anil08607/stm32-smartwatch/release/README.md

# Engineering review package

Status: REVIEW_ONLY_NOT_ORDER_APPROVED. Native DRC/ERC and routed-viewer checks can pass while physical qualification remains pending. Read readiness.json, qualification.json, ../docs/fabrication.md and ../docs/assembly.md before ordering.

Gerbers, Excellon drills, top-only SMT BOM/CPL and complete purchase list share the same reviewed source. M1 is excluded from SMT/paste. Stock is not reserved.
