anil08607/stm32-smartwatch/mechanical/index.html

ANIL / HARDWARE V1

# nRF52810 Smartwatch

Provisional fit model

Compact and exploded assembly with the full electronics and mechanical parts list.

PCB: 46 × 46 × 1 mm
Case: 54 × 54 × 18 mm
Strap: 22 mm
Loading assembly…

Explode assembly Show internalsFit whole watchInspect watch headInspect USB accessInspect centred buttons

Compact GLBExploded GLB

Supplier fit, flex routing, battery pack protection, RF tuning and first-article tests remain release gates. Component bodies and harnesses are envelopes. The clock face is illustrative.

Loading…
