anil08607/stm32-smartwatch/__snapshots__/SMARTWATCH_V1_STM32.circuit-3d.snap.png

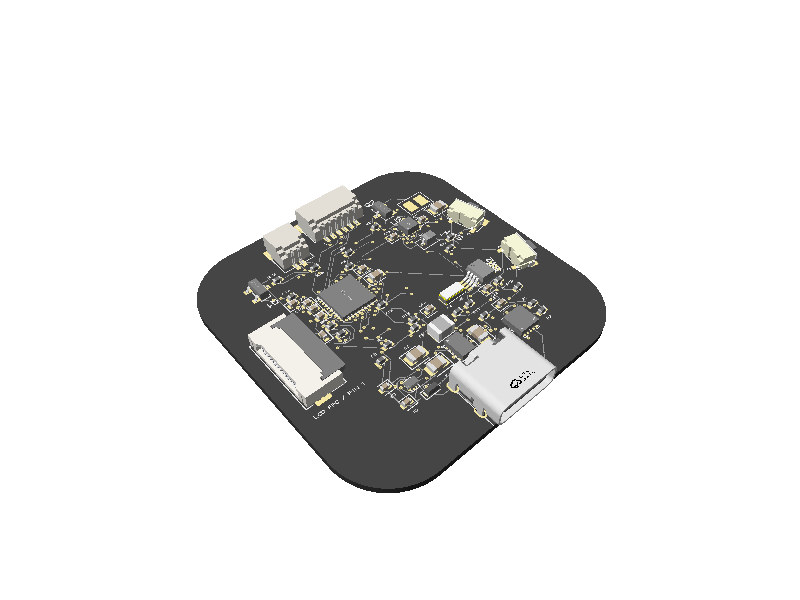
__snapshots__/SMARTWATCH_V1_STM32.circuit-3d.snap.png
