anil08607/stm32-smartwatch/bom.csv

Reference | Quantity per watch | Manufacturer part | Supplier code | Purchase URL | Assembly stage | Procurement status
PCB1 | 1 | 46 x 46 mm, four layers, 1 mm FR-4, ENIG; release Gerbers and drills |  | https://jlcpcb.com/ | Bare PCB fabrication | Fabricator stackup, impedance and engineering release approval pending
SMT_SERVICE | 1 | Top-side SMT assembly of 70 fitted parts; exact BOM/CPL |  | https://jlcpcb.com/pcb-assembly | Before external product assembly | Assembler orientation, stencil and inspection approval pending
J1 | 1 | TYPE-C-31-M-12 | C165948 | https://jlcpcb.com/partdetail/C165948 | Top SMT assembly | Inventory available as of 2026-10-15T14:10:25.200Z; not reserved
U3 | 1 | HUSB238_002DD | C7471904 | https://jlcpcb.com/partdetail/C7471904 | Top SMT assembly | Inventory available as of 2026-10-15T14:10:25.200Z; not reserved
R18 | 1 | 0402WGF100JTCE | C25077 | https://jlcpcb.com/partdetail/C25077 | Top SMT assembly | Inventory available as of 2026-10-15T14:10:25.200Z; not reserved
C6,C1,C3,C11 | 4 | CL05A105KA5NQNC | C52923 | https://jlcpcb.com/partdetail/C52923 | Top SMT assembly | Inventory available as of 2026-10-15T14:10:25.200Z; not reserved
R1,R2 | 2 | 0402WGF0000TCE | C17168 | https://jlcpcb.com/partdetail/C17168 | Top SMT assembly | Inventory available as of 2026-10-15T14:10:25.200Z; not reserved
D1 | 1 | LESD5Z5.0CT1G | C136167 | https://jlcpcb.com/partdetail/C136167 | Top SMT assembly | Inventory available as of 2026-10-15T14:10:25.200Z; not reserved
U5 | 1 | BQ25180YBGR | C3682423 | https://jlcpcb.com/partdetail/C3682423 | Top SMT assembly | Inventory available as of 2026-10-15T14:10:25.200Z; not reserved
C2,C4 | 2 | CL21A106KAYNNNE | C15850 | https://jlcpcb.com/partdetail/C15850 | Top SMT assembly | Inventory available as of 2026-10-15T14:10:25.200Z; not reserved
J5,J2 | 2 | SM02B-SRSS-TB(LF)(SN) | C160402 | https://jlcpcb.com/partdetail/C160402 | Top SMT assembly | Inventory available as of 2026-10-15T14:10:25.200Z; not reserved
R7,R10,R17 | 3 | 0402WGF1002TCE | C25744 | https://jlcpcb.com/partdetail/C25744 | Top SMT assembly | Inventory available as of 2026-10-15T14:10:25.200Z; not reserved
U6 | 1 | TPS63802DLAR | C2845237 | https://jlcpcb.com/partdetail/C2845237 | Top SMT assembly | Inventory available as of 2026-10-15T14:10:25.200Z; not reserved
L1 | 1 | DFE252012P-R47M=P2 | C237552 | https://jlcpcb.com/partdetail/C237552 | Top SMT assembly | Inventory available as of 2026-10-15T14:10:25.200Z; not reserved
C5,C23 | 2 | CL21A226MAQNNNE | C45783 | https://jlcpcb.com/partdetail/C45783 | Top SMT assembly | Inventory available as of 2026-10-15T14:10:25.200Z; not reserved
R4 | 1 | RC0402FR-07510KL | C137961 | https://jlcpcb.com/partdetail/C137961 | Top SMT assembly | Inventory available as of 2026-10-15T14:10:25.200Z; not reserved
R5,R6,R16,R19,R20,R22 | 6 | 0402WGF1003TCE | C25741 | https://jlcpcb.com/partdetail/C25741 | Top SMT assembly | Inventory available as of 2026-10-15T14:10:25.200Z; not reserved
U1 | 1 | NRF52810-QFAA-R | C141828 | https://jlcpcb.com/partdetail/C141828 | Top SMT assembly | Inventory available as of 2026-10-15T14:10:25.200Z; not reserved
C8,C10,C13,C14,C15,C16,C17,C22,C25,C26,C27 | 11 | CC0402KRX7R7BB104 | C60474 | https://jlcpcb.com/partdetail/C60474 | Top SMT assembly | Inventory available as of 2026-10-15T14:10:25.200Z; not reserved
C9 | 1 | 0402CG101J500NT | C1546 | https://jlcpcb.com/partdetail/C1546 | Top SMT assembly | Inventory available as of 2026-10-15T14:10:25.200Z; not reserved
C12 | 1 | CL10A475KO8NNNC | C19666 | https://jlcpcb.com/partdetail/C19666 | Top SMT assembly | Inventory available as of 2026-10-15T14:10:25.200Z; not reserved
R8,R9 | 2 | 0402WGF4701TCE | C25900 | https://jlcpcb.com/partdetail/C25900 | Top SMT assembly | Inventory available as of 2026-10-15T14:10:25.200Z; not reserved
R12 | 1 | 0402WGF1004TCE | C26083 | https://jlcpcb.com/partdetail/C26083 | Top SMT assembly | Inventory available as of 2026-10-15T14:10:25.200Z; not reserved
R13 | 1 | 0402WGF3303TCE | C25778 | https://jlcpcb.com/partdetail/C25778 | Top SMT assembly | Inventory available as of 2026-10-15T14:10:25.200Z; not reserved
J3 | 1 | SM06B-SRSS-TB(LF)(SN) | C160405 | https://jlcpcb.com/partdetail/C160405 | Top SMT assembly | Inventory available as of 2026-10-15T14:10:25.200Z; not reserved
J4 | 1 | AFC24-S15FIA-00 | C6709462 | https://jlcpcb.com/partdetail/C6709462 | Top SMT assembly | Inventory available as of 2026-10-15T14:10:25.200Z; not reserved
R14 | 1 | 0402WGF220JTCE | C25092 | https://jlcpcb.com/partdetail/C25092 | Top SMT assembly | Inventory available as of 2026-10-15T14:10:25.200Z; not reserved
Q1 | 1 | 2N7002 | C8545 | https://jlcpcb.com/partdetail/C8545 | Top SMT assembly | Inventory available as of 2026-10-15T14:10:25.200Z; not reserved
R15,R21 | 2 | 0402WGF1000TCE | C25076 | https://jlcpcb.com/partdetail/C25076 | Top SMT assembly | Inventory available as of 2026-10-15T14:10:25.200Z; not reserved
U2 | 1 | BMA456 | C189518 | https://jlcpcb.com/partdetail/C189518 | Top SMT assembly | Inventory available as of 2026-10-15T14:10:25.200Z; not reserved
U4 | 1 | PCF8563TS/5,118 | C27397 | https://jlcpcb.com/partdetail/C27397 | Top SMT assembly | Inventory available as of 2026-10-15T14:10:25.200Z; not reserved
Y1 | 1 | FC-135 32.7680KA-AG3 | C7275970 | https://jlcpcb.com/partdetail/C7275970 | Top SMT assembly | Inventory available as of 2026-10-15T14:10:25.200Z; not reserved
SW1,SW2 | 2 | TS-1806SA-2x4x3.5DY-180X | C51927172 | https://jlcpcb.com/partdetail/C51927172 | Top SMT assembly | Inventory available as of 2026-10-15T14:10:25.200Z; not reserved
Q2 | 1 | AO3400A | C20917 | https://jlcpcb.com/partdetail/C20917 | Top SMT assembly | Inventory available as of 2026-10-15T14:10:25.200Z; not reserved
D2 | 1 | 1N5819WS | C5451629 | https://jlcpcb.com/partdetail/C5451629 | Top SMT assembly | Inventory available as of 2026-10-15T14:10:25.200Z; not reserved
Y2 | 1 | X201632MKB4SI | C718072 | https://jlcpcb.com/partdetail/C718072 | Top SMT assembly | Inventory available as of 2026-10-15T14:10:25.200Z; not reserved
Y3 | 1 | ABS07-32.768KHZ-9-T | C179635 | https://jlcpcb.com/partdetail/C179635 | Top SMT assembly | Inventory available as of 2026-10-15T14:10:25.200Z; not reserved
ANT1 | 1 | RFANT3216120A5T | C127629 | https://jlcpcb.com/partdetail/C127629 | Top SMT assembly | Inventory available as of 2026-10-15T14:10:25.200Z; not reserved
L2 | 1 | LQG15HS3N9S02D | C77109 | https://jlcpcb.com/partdetail/C77109 | Top SMT assembly | Inventory available as of 2026-10-15T14:10:25.200Z; not reserved
L3 | 1 | LQG15HS6N8J02D | C77110 | https://jlcpcb.com/partdetail/C77110 | Top SMT assembly | Inventory available as of 2026-10-15T14:10:25.200Z; not reserved
C24 | 1 | GJM1555C1HR80WB01D | C88902 | https://jlcpcb.com/partdetail/C88902 | Top SMT assembly | Inventory available as of 2026-10-15T14:10:25.200Z; not reserved
C28,C29,C30,C31 | 4 | 0402CG120J500NT | C1547 | https://jlcpcb.com/partdetail/C1547 | Top SMT assembly | Inventory available as of 2026-10-15T14:10:25.200Z; not reserved
LCD1 | 1 | ER-TFT1.28-3, no-touch, 15-pin 0.5 mm FPC |  | https://www.buydisplay.com/1-28-inch-tft-lcd-display-240x240-round-circle-screen-for-smart-watch | After reflow; verify flex contact orientation | supplier confirmation required
BT1 | 1 | LP403035 3.7 V 400 mAh protected 1S LiPo; confirmed JST-SH polarity and protection required |  | https://www.lipolbattery.com/LiPo-Battery-Datahseet/LiPo_Battery_LP403035_3.7V_400mAh.pdf | Qualified custom pack order; do not substitute bare unprotected cell | pack quote, protection circuit and lead drawing required
NTC1 | 1 | SEMITEC 103AT-2 10 kohm 3435 K thermistor |  | https://www.arrow.com/en/products/103at-2/semitec-corporation | Insulate and bond to pack; connect to J5; test open/short faults | supplier confirmation required
M1 | 1 | LCM1234A3523F wire-lead vibration motor | C7424783 | https://www.lcsc.com/product-detail/C7424783.html | Hand-solder to M1 pads; no SMT paste or CPL entry | supplier confirmation required
H_BAT,H_NTC | 2 | JST SHR-02V-S housing with two SSH-003T-P0.2 contacts, assembled 28 AWG lead, nominal 50 mm |  | https://www.jst-mfg.com/product/index.php?series=231 | One polarized battery lead, one marked NTC lead; verify actual cut length | harness quote required
H_SWD | 1 | JST SHR-06V-S housing with six SSH-003T-P0.2 contacts and probe-specific adapter |  | https://www.jst-mfg.com/product/index.php?series=231 | Programming equipment; custom pinout in hardware-contract.json | harness quote required
CASE1,BEZEL1,RETAINER1,PLUNGER1,PLUNGER2 | 1 | Custom five-part polymer enclosure set from mechanical/ STL models |  | https://3d.jlcpcb.com/ | Prototype print quote; inspect fit and refine before wearable use | custom manufacture; no stock claim
LENS1 | 1 | Custom 38 x 40 x 1 mm clear polycarbonate lens, R3 corners |  | https://www.protolabs.com/services/cnc-machining/ | Custom cut lens; bond after display fit check | custom quote required
FAST1 | 4 | M2 x 8 mm screws with M2 heat-set inserts sized to enclosure drawing |  | https://www.mcmaster.com/heat-set-inserts/ | Case fastening; verify insert OD and installed depth with supplier drawing | exact insert selection and fit test required
STRAP1 | 1 | 22 mm silicone quick-release strap with two matching spring bars |  | https://www.bartonwatchbands.com/collections/22mm-watch-bands | Final mechanical assembly; verify lug and pin fit | supplier confirmation required
ADH1 | 1 | Electronics-safe 0.10 mm display seat tape, 0.20 mm lens perimeter bond, 0.5 mm battery cushion and insulated NTC bond; exact compatible grades pending |  | https://www.3m.com/3M/en_US/bonding-and-assembly-us/ | Select materials compatible with pack supplier and temperature limits | exact adhesive selection required
TOOL_SWD | 1 | Nordic nRF52 DK debug-out or compatible SEGGER J-Link |  | https://www.nordicsemi.com/Products/Development-hardware/nRF52-DK | Reusable programming/test equipment; not fitted to watch | supplier confirmation required
TOOL_USB | 1 | 5 V USB-C source and USB-C cable |  | https://www.digikey.com/en/products/filter/usb-cables/455 | Charging/test equipment; cable overmould at most 12 mm wide x 6 mm high within checked side-opening envelope; verify full engagement | exact cable/source selection required
