anil08607/stm32-smartwatch/mechanical/case-base.stl

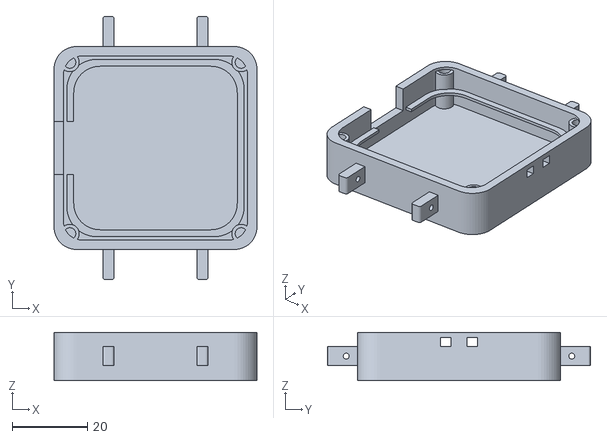
[picture p2: CAD file, 2026-10-15]
mechanical/case-base.stl
54.0 x 70.0 x 12.8
