anil08607/stm32-smartwatch/mechanical/display-retainer.stl

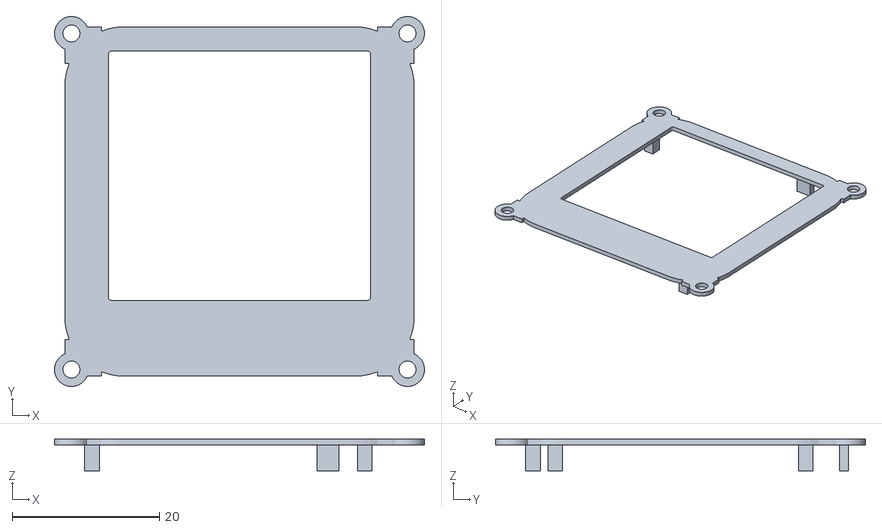
[picture p3: CAD file, 2026-10-15]
mechanical/display-retainer.stl
50.2 x 50.2 x 4.30
