anil08607/stm32-smartwatch/mechanical/button-plunger-SW1.stl

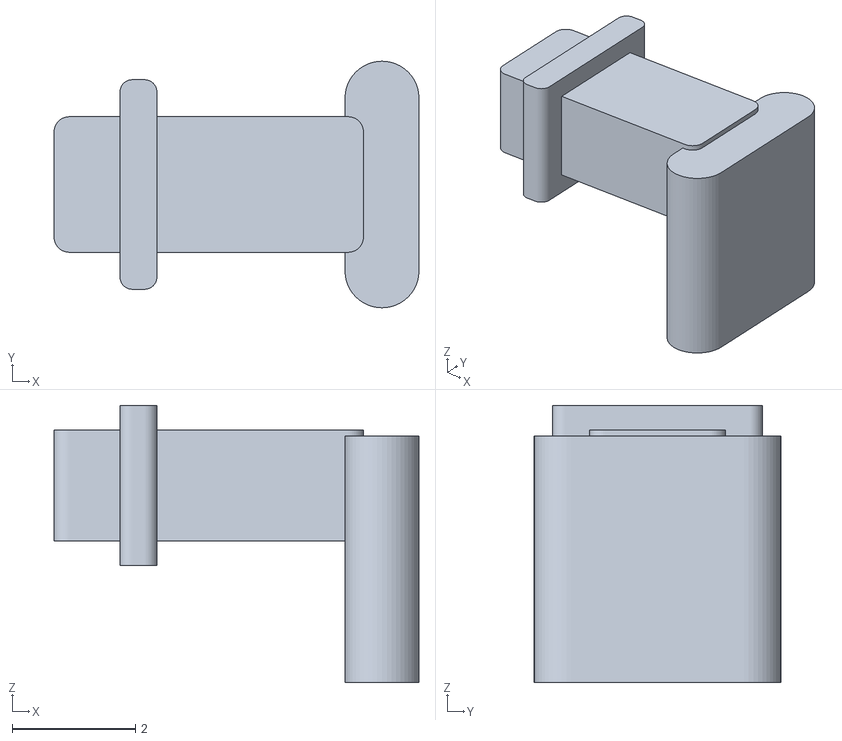
[picture p4: CAD file, 2026-10-15]
mechanical/button-plunger-SW1.stl
5.92 x 4.00 x 4.50
