anil08607/stm32-smartwatch/mechanical/bezel.stl

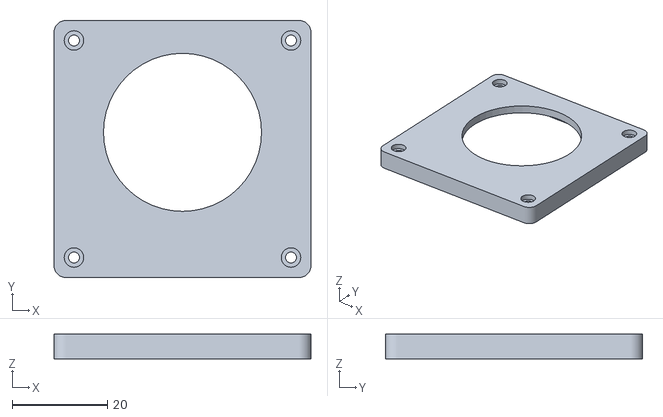
[picture p5: CAD file, 2026-10-15]
mechanical/bezel.stl
54.0 x 54.0 x 5.20
