anil08607/stm32-smartwatch/mechanical/button-plunger-10.stl

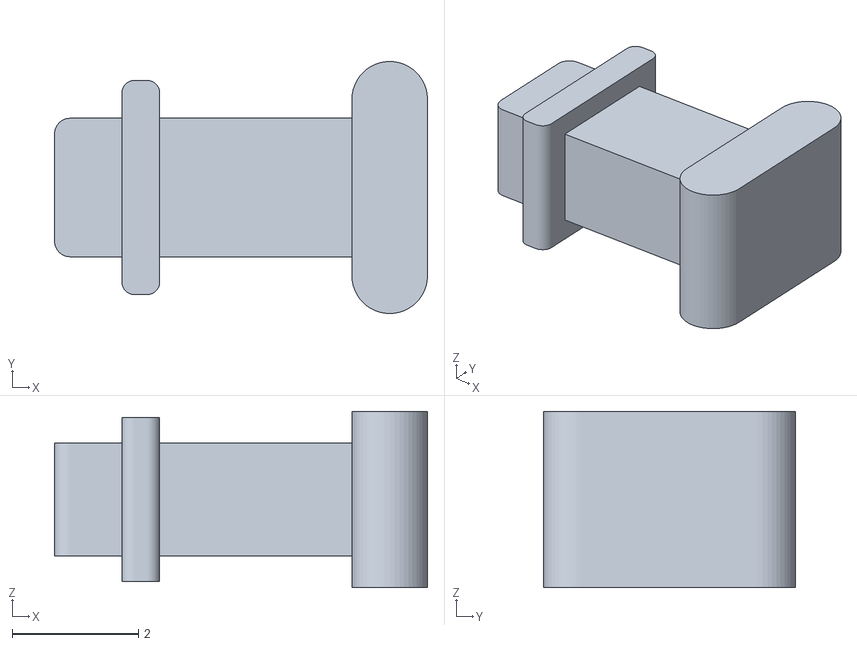
[picture p6: CAD file, 2026-10-15]
mechanical/button-plunger-10.stl
5.92 x 4.00 x 2.80
