anil08607/stm32-smartwatch/(list of files, cad)

Other CAD files:
mechanical/button-plunger-SW2.stl
mechanical/button-plunger-2.stl
