anil08607/stm32-smartwatch/(list of files, drawings)

Other design files:
docs/checks/schematic-style.json
hardware/schematic-paths.json
routing/native/input.dsn
