anil08607/stm32-smartwatch/hardware/smartwatch-nrf52810.kicad_pcb

## KiCad design hardware/smartwatch-nrf52810.kicad_pcb (2026-10-15)

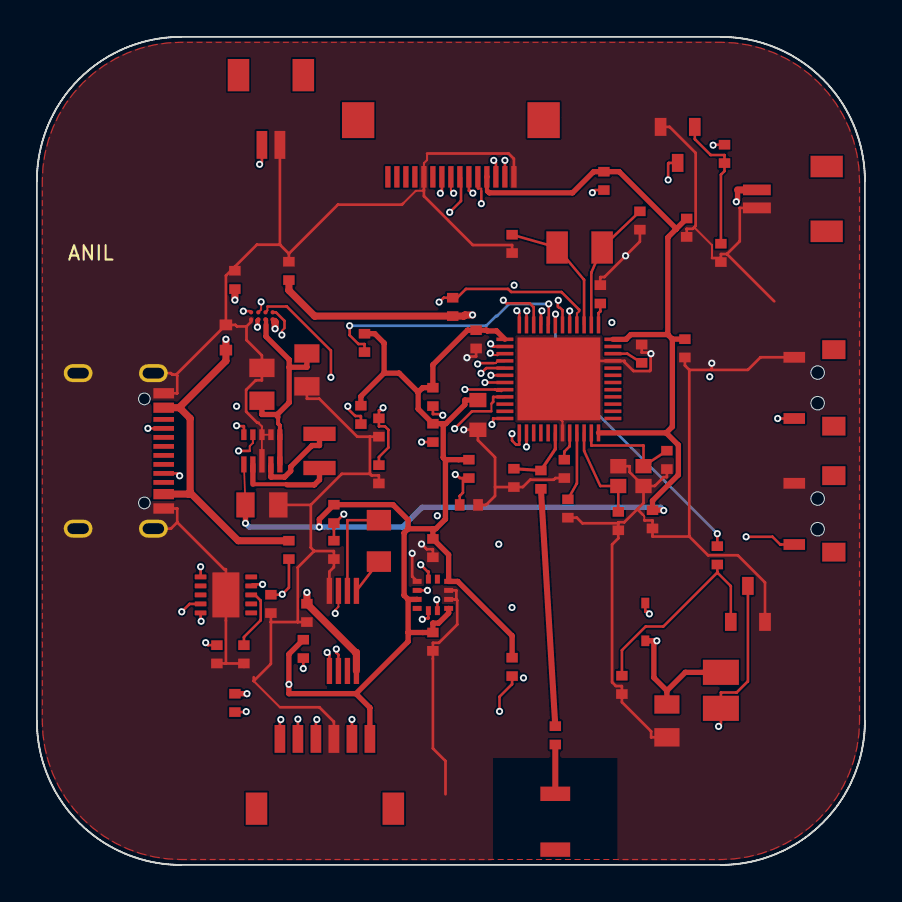
[picture p7: board smartwatch-nrf52810.kicad_pcb from above]

Board: 4 copper layers, 46.0 x 46.0 mm, 71 parts (0 on the bottom side), 53 nets.

Parts:
ANT1: RFANT3216120A5T; ANT1_exact
C1: 1uF; C1_exact
C2: 10uF; C2_exact
C3: 1uF; C3_exact
C4: 10uF; C4_exact
C5: 22uF; C5_exact
C6: 1uF; C6_exact
C8: 100nF; C8_exact
C9: 100pF; C9_exact
C10: 100nF; C10_exact
C11: 1uF; C11_exact
C12: 4.7uF; C12_exact
C13: 100nF; C13_exact
C14: 100nF; C14_exact
C15: 100nF; C15_exact
C16: 100nF; C16_exact
C17: 100nF; C17_exact
C22: 100nF; C22_exact
C23: 22uF; C23_exact
C24: 0.8pF; C24_exact
C25: 100nF; C25_exact
C26: 100nF; C26_exact
C27: 100nF; C27_exact
C28: 12pF; C28_exact
C29: 12pF; C29_exact
C30: 12pF; C30_exact
C31: 12pF; C31_exact
D1: D; D1_exact
D2: D; D2_exact
J1: J1; J1_exact
J2: J2; J2_exact
J3: J3; J3_exact
J4: J4; J4_exact
J5: J5; J5_exact
L1: 470nH; L1_exact
L2: 3.9nH; L2_exact
L3: 6.8nH; L3_exact
M1: M1; M1_exact
Q1: Q1; Q1_exact
Q2: Q2; Q2_exact
R1: 0Ω; R1_exact
R2: 0Ω; R2_exact
R4: 510kΩ; R4_exact
R5: 100kΩ; R5_exact
R6: 100kΩ; R6_exact
R7: 10kΩ; R7_exact
R8: 4.7kΩ; R8_exact
R9: 4.7kΩ; R9_exact
R10: 10kΩ; R10_exact
R12: 1MΩ; R12_exact
R13: 330kΩ; R13_exact
R14: 22Ω; R14_exact
R15: 100Ω; R15_exact
R16: 100kΩ; R16_exact
R17: 10kΩ; R17_exact
R18: 10Ω; R18_exact
R19: 100kΩ; R19_exact
R20: 100kΩ; R20_exact
R21: 100Ω; R21_exact
R22: 100kΩ; R22_exact
SW1: SW1; SW1_exact
SW2: SW2; SW2_exact
U1: NRF52810-QFAA-R; U1_exact
U2: BMA456; U2_exact
U3: HUSB238_002DD; U3_exact
U4: PCF8563TS/5,118; U4_exact
U5: BQ25180YBGR; U5_exact
U6: TPS63802DLAR; U6_exact
Y1: Y1; Y1_exact
Y2: Y2; Y2_exact
Y3: Y3; Y3_exact

Connections:
BAT: C3.1, C22.1, J2.1, R12.1, U4.8, U5.6
BAT_ADC: C14.1, R12.2, R13.1, U1.4
BMA_INT1: U1.18, U2.5
BMA_INT2: U1.19, U2.6
BQ_TS: J5.1, U5.7
BUCK_FB: R4.2, R5.1, U6.4
BUCK_L1: L1.1, U6.9
BUCK_L2: L1.2, U6.7
BUCK_PG: R6.2, U6.5
BUTTON1: R19.2, SW1.1, U1.5
BUTTON2: R20.2, SW2.1, U1.6
CHG_INT: R7.2, U1.8, U5.1
DEBUG_GPIO: J3.6, U1.21
DISPLAY_LEDA: J4.3, R14.2
DISPLAY_LED_K: J4.2, Q1.3
GND: C1.2, C2.2, C3.2, C4.2, C5.2, C6.2, C8.2, C9.2, C10.2, C11.2, C12.2, C13.2, C14.2, C15.2, C16.2, C17.2, C22.2, C23.2, C24.2, C25.2, C26.2, C27.2, C28.2, C29.2, C30.2, C31.2, D1.1, J1.1, J1.12, J1.13, J1.14, J1.15, J1.16, J2.2, J3.3, J4.1, J4.11, J5.2, Q1.2, Q2.2, R1.2, R2.2, R5.2, R13.2, R16.2, R22.2, SW1.2, SW2.2, U1.31, U1.45, U1.49, U2.1, U2.8, U2.9, U3.11, U4.4, U5.8, U6.2, U6.3, U6.8, Y2.2, Y2.4
HF_X1: C28.1, U1.34, Y2.1
HF_X2: C29.1, U1.35, Y2.3
I2C_SCL: R8.2, U1.16, U2.12, U4.6, U5.3
I2C_SDA: R9.2, U1.17, U2.2, U4.5, U5.5
LCD_BL: R15.1, U1.15
LCD_BL_GATE: Q1.1, R15.2, R16.1
LCD_CS: J4.6, U1.9
LCD_DC: J4.5, U1.12
LCD_MOSI: J4.8, U1.11
LCD_RESET: J4.9, U1.14
LCD_SCK: J4.7, U1.10
LF_X1: C30.1, U1.2, Y3.1
LF_X2: C31.1, U1.3, Y3.2
MOTOR_EN: R21.1, U1.7
MOTOR_GATE: Q2.1, R21.2, R22.1
MOTOR_NEG: D2.1, M1.2, Q2.3
NRF_DEC1: C8.1, U1.1
NRF_DEC2: C9.1, U1.32
NRF_DEC3: C10.1, U1.33
NRF_DEC4: C11.1, U1.46
NRST: C13.1, J3.5, R10.2, U1.24
PD_ISET: R2.1, U3.9
PD_VIN: C6.1, R18.2, U3.1
PD_VSET: R1.1, U3.8
RF_50: L2.2, L3.1
RF_ANT: C24.1, L2.1, U1.30
RF_FEED: ANT1.1, L3.2
RTC_INT: R17.2, U1.20, U4.3
RTC_OSCI: U4.1, Y1.1
RTC_OSCO: U4.2, Y1.2
SWCLK: J3.4, U1.25
SWDIO: J3.2, U1.26
SYS: C2.1, C4.1, U5.4, U6.1, U6.10
USB5V: C1.1, D1.2, J1.2, J1.11, R18.1, U5.2
USB_CC1: J1.4, U3.4
USB_CC2: J1.9, U3.5
V3V0: C5.1, C12.1, C15.1, C16.1, C17.1, C23.1, C25.1, C26.1, C27.1, D2.2, J3.1, J4.4, M1.1, R4.1, R6.1, R7.1, R8.1, R9.1, R10.1, R14.1, R17.1, R19.1, R20.1, U1.13, U1.36, U1.48, U2.3, U2.7, U2.10, U6.6
