anil08607/stm32-smartwatch/(commit log)

2026-08-29 Add martwatch
    [bom.csv]
2026-09-07 resolve cooments
    [bom.csv]
2026-09-08 replace stock compoenents
    [bom-jlcpcb.csv, bom.csv]
2026-10-05 feat: complete rounded-square smartwatch PCB with USB-C PD
2026-10-15 Canonicalize generated circuit fingerprints across build platforms
2026-10-15 Fix hosted builds and expose the complete smartwatch assembly
2026-10-15 Keep the display visible in browser CAD and refresh CI runtimes
2026-10-15 Move charging port opposite centred buttons and reroute the assembly
